ngergihun/stepperController/schematics/3axisMotorController_Schematics.pdf

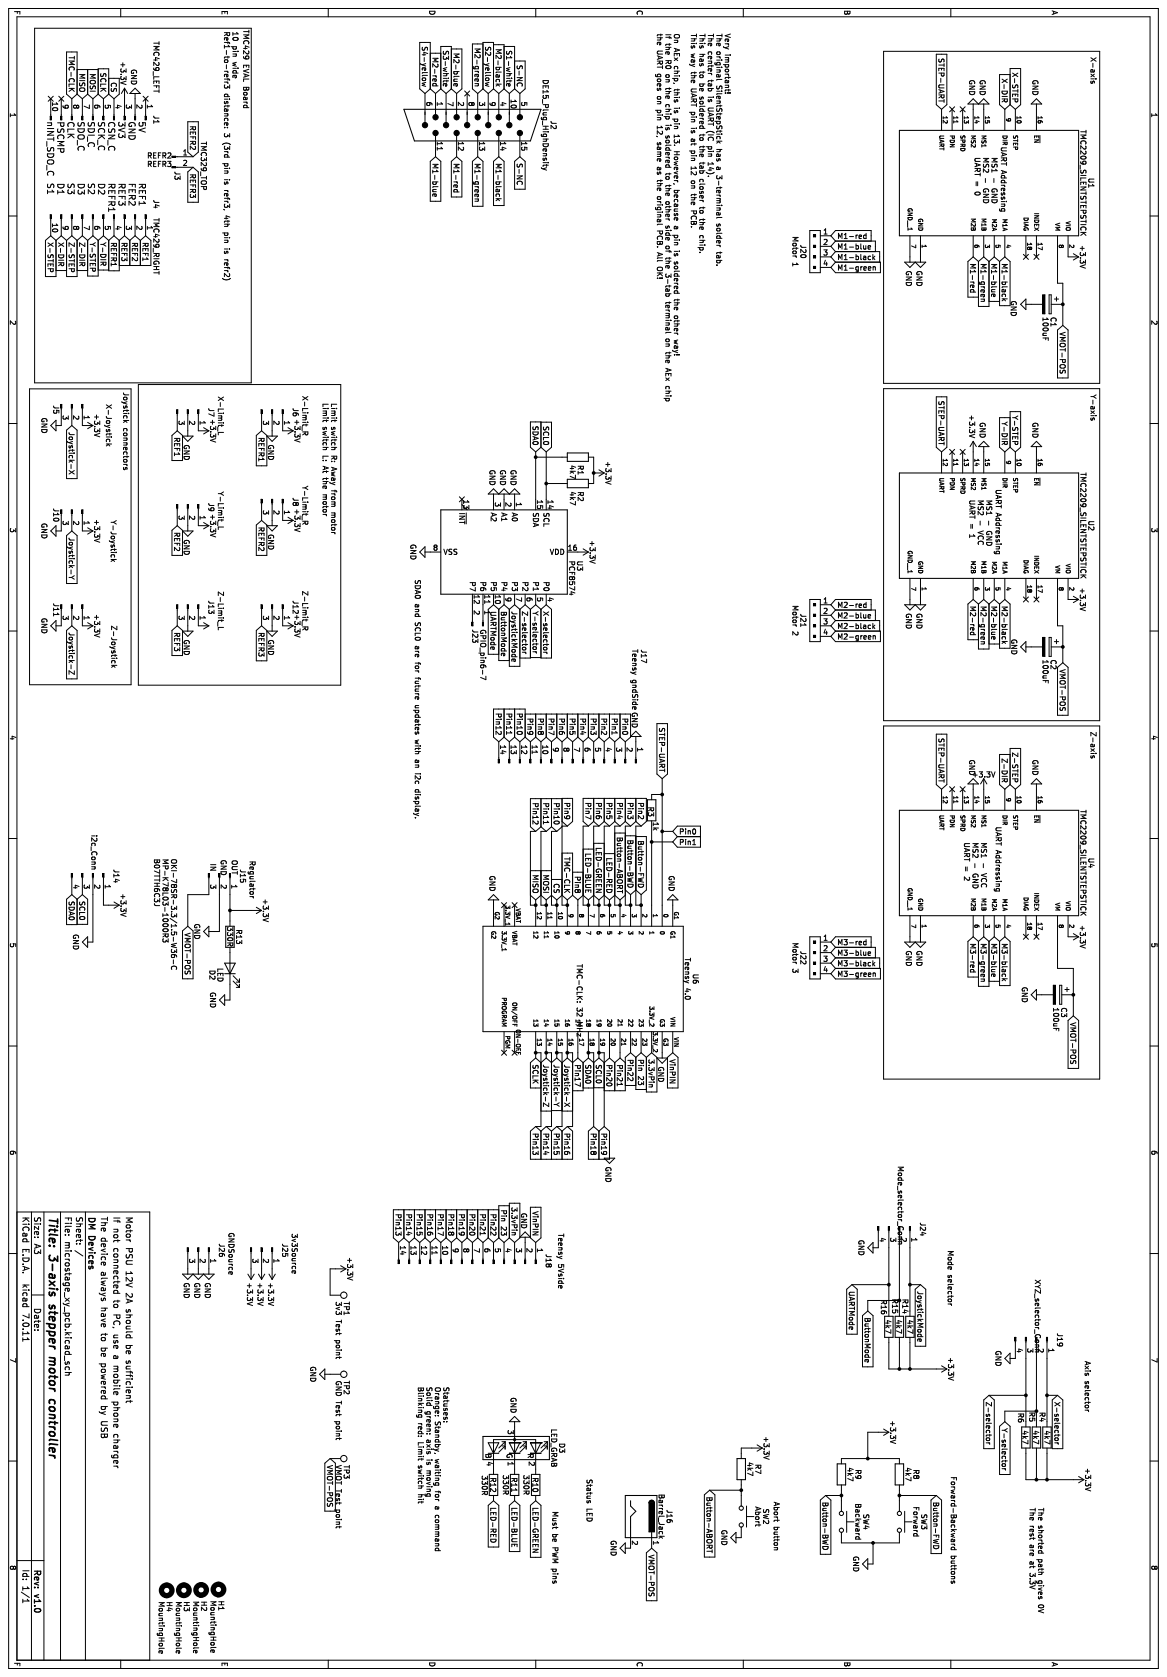
[picture p8: page 1]
