ngergihun/stepperController/software/SerialParser/cmd.py

""" This file contains a dictionary of commands that the devices can accept in 
three different categories: get, set, move. For each command, it returns the 
instruction code to send to the device. """

from enum import Enum

get_ = {
    "position": "gp",
    "switchstate": "gs",
    "settings": "gv",
    "status": "mo"
}

set_ = {
    "mode": "mm",
    "targetspeed": "tv",
    "microsteps": "sm",
    "maxspeed": "sv",
    "maxacceleration": "sa",
    "switches": "es",
    "advancedstop": "as",
    "motorswitch": "ss",
    "position": "sp"
}

mov_ = {
    "absolute": "ma",
    "relative": "mr",
    "home": "mh",
    "autotune": "at",
}

shutter_ = {
    "move": "MV",
    "set_position": "SP",
    "get_position": "GP",
}

switch_ = {
    "get_state": "GS"
}

class move_modes(Enum):
    """Movement modes supported by the motor controller."""
    soft = 0
    ramp = 1
    velocity = 2
    hold = 3

def commands():
    """Return the command groups accepted by the device.

    Returns
    -------
    dict
        Dictionary containing ``get``, ``set``, and ``move`` command maps.
    """
    return {"get": get_, "set": set_, "move": mov_}

if __name__ == "__main__":
    cmds = commands()
    print(cmds)
