ngergihun/stepperController/(commit log)

2024-07-11 Folder for arduino IDE
2024-07-13 movemode + switches + 2d
2024-07-14 Set velocity command added
2024-07-14 Set valocity test print
2024-07-18 Limit switch update fix1
    [3axisMotorController.ino]
2024-08-05 Get switch state added
